Gouri-Shankar-85/VX-01/vx01_ws/src/vx01_control/aquatic/vx01_aquatic_control/README.md

# vx01_aquatic_control

Control nodes for future underwater locomotion integration.

---

## Package Structure

```
vx01_aquatic_control/
├── CMakeLists.txt
├── include
│   └── vx01_aquatic_control
├── package.xml
├── README.md
└── src

3 directories, 3 files
```

---

## Build

From the VX-01 workspace root:

```bash
cd ~/vx01_ws
colcon build --packages-select vx01_aquatic_control
source install/setup.bash
```
