Gouri-Shankar-85/VX-01/vx01_ws/src/vx01_control/locomotion/kinematics_reference/leg.JPG

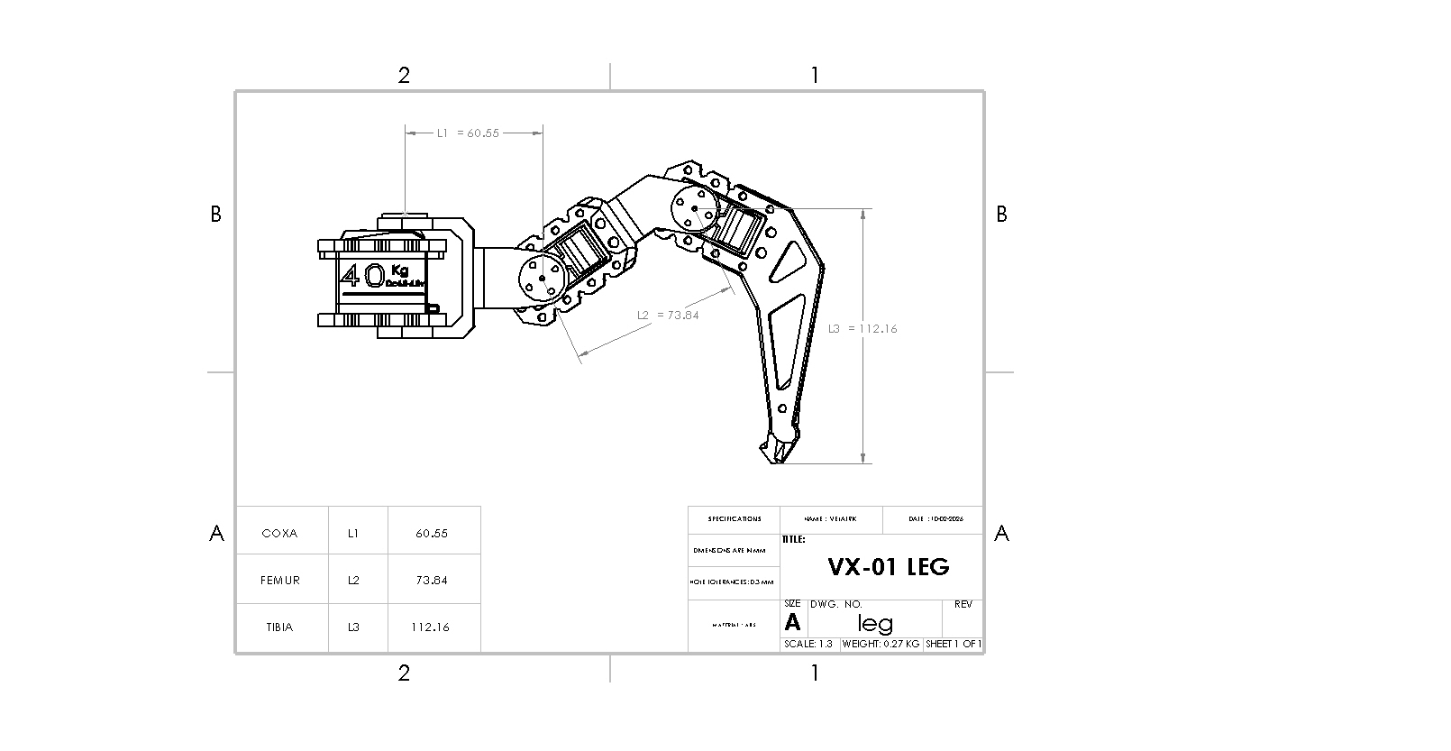
vx01_ws/src/vx01_control/locomotion/kinematics_reference/leg.JPG
