Gouri-Shankar-85/VX-01/vx01_ws/src/vx01_description/meshes/drone/prop_link_1.STL

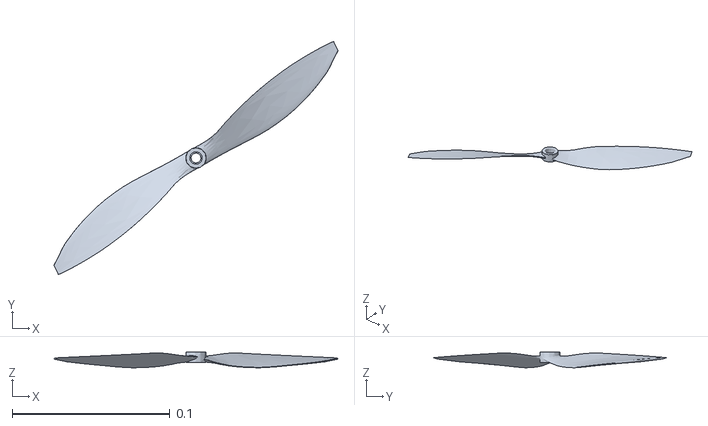
[picture p5: CAD file, 2026-02-22]
vx01_ws/src/vx01_description/meshes/drone/prop_link_1.STL
0.18 x 0.148 x 0.00996
