Gouri-Shankar-85/VX-01/vx01_ws/src/vx01_description/meshes/hexapod/tibia_link_5.STL

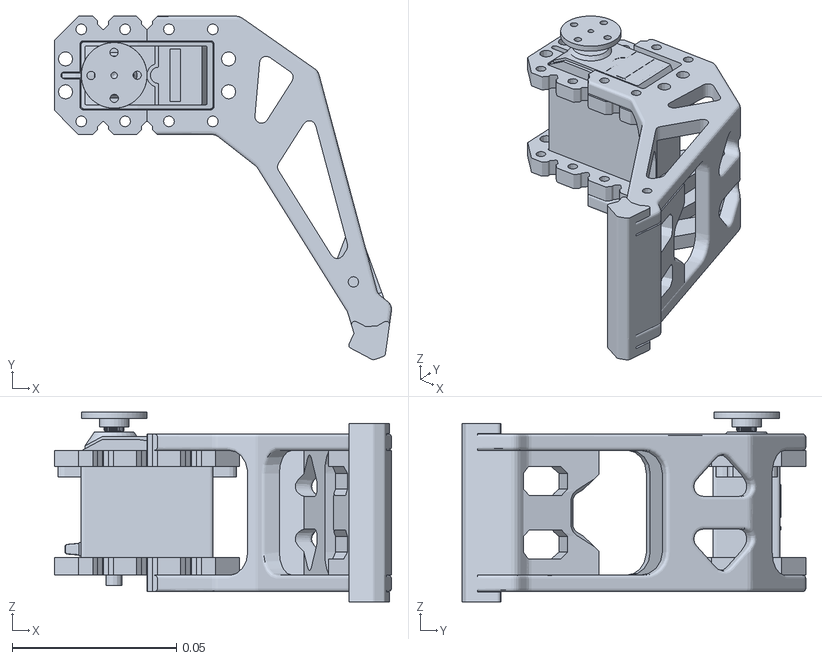
[picture p6: CAD file, 2026-02-22]
vx01_ws/src/vx01_description/meshes/hexapod/tibia_link_5.STL
0.103 x 0.105 x 0.0577
