Gouri-Shankar-85/VX-01/vx01_ws/src/vx01_description/meshes/sensors/depth_camera_link.STL

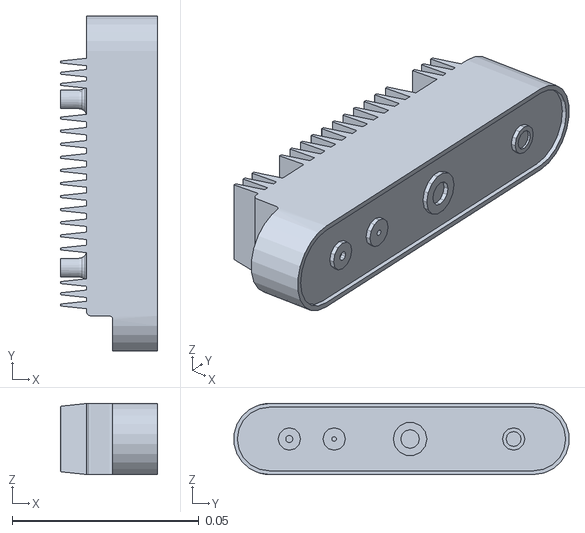
[picture p7: CAD file, 2026-02-19]
vx01_ws/src/vx01_description/meshes/sensors/depth_camera_link.STL
0.026 x 0.0896 x 0.019
