Gouri-Shankar-85/VX-01/vx01_ws/src/vx01_description/meshes/hexapod/femur_link_0.STL

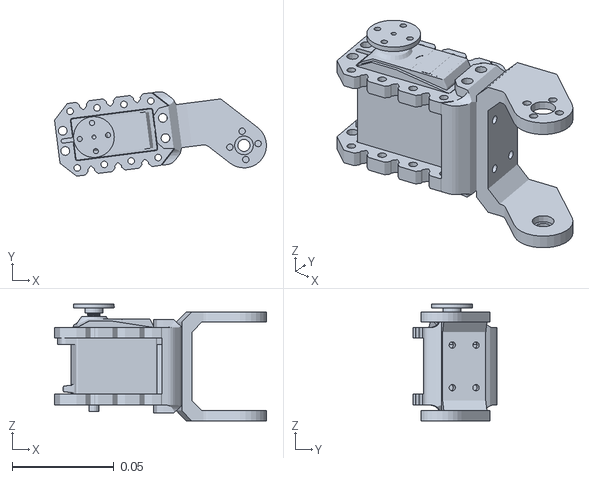
[picture p8: CAD file, 2026-02-22]
vx01_ws/src/vx01_description/meshes/hexapod/femur_link_0.STL
0.104 x 0.0415 x 0.0574
