Gouri-Shankar-85/VX-01/vx01_ws/src/vx01_description/meshes/sensors/imu_link.STL

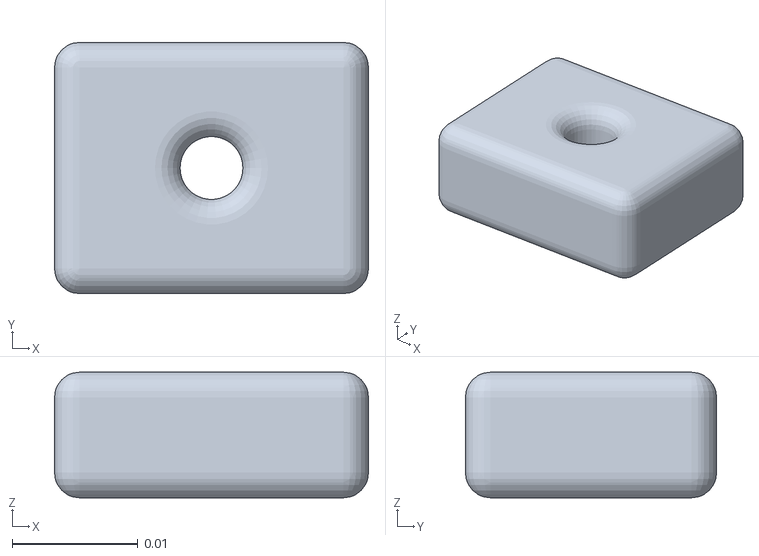
[picture p9: CAD file, 2026-02-19]
vx01_ws/src/vx01_description/meshes/sensors/imu_link.STL
0.025 x 0.02 x 0.01
