Gouri-Shankar-85/VX-01/vx01_ws/src/vx01_description/meshes/sensors/lidar_link.STL

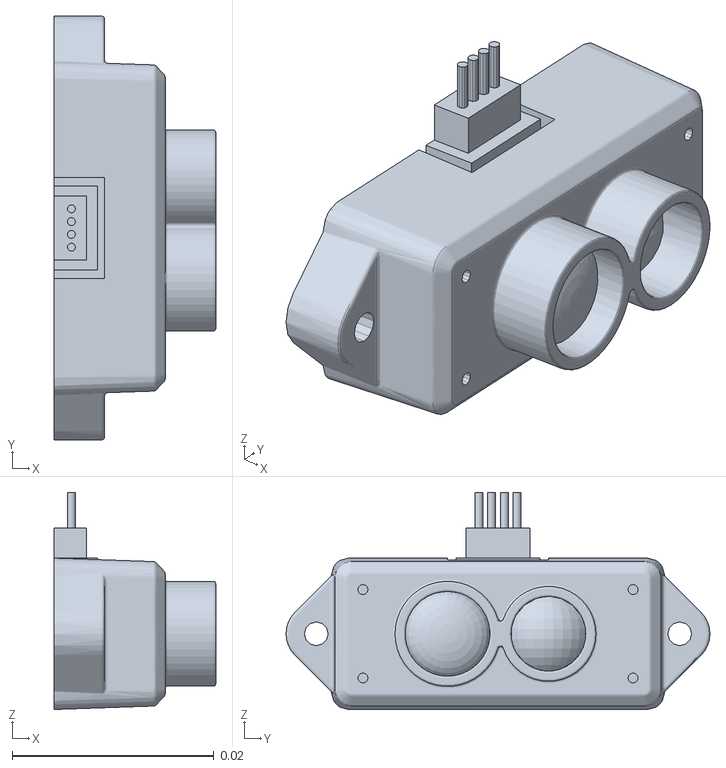
[picture p10: CAD file, 2026-02-19]
vx01_ws/src/vx01_description/meshes/sensors/lidar_link.STL
0.016 x 0.042 x 0.0215
