Gouri-Shankar-85/VX-01/vx01_ws/src/vx01_description/meshes/hexapod/femur_link_1.STL

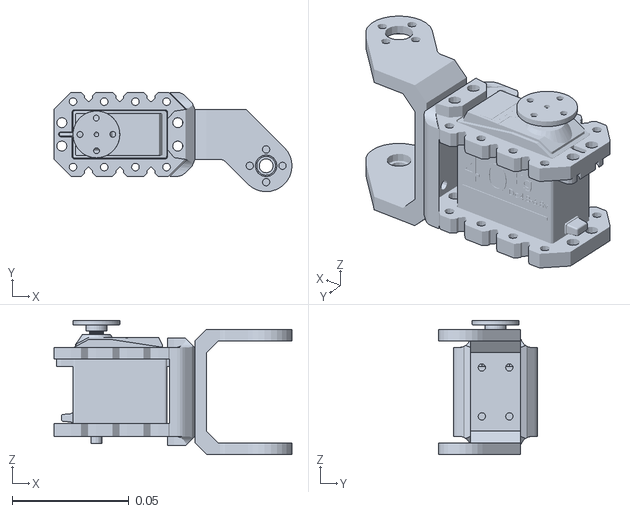
[picture p11: CAD file, 2026-02-22]
vx01_ws/src/vx01_description/meshes/hexapod/femur_link_1.STL
0.102 x 0.0425 x 0.0574
