Gouri-Shankar-85/VX-01/vx01_ws/src/vx01_description/meshes/hexapod/coxa_link_1.STL

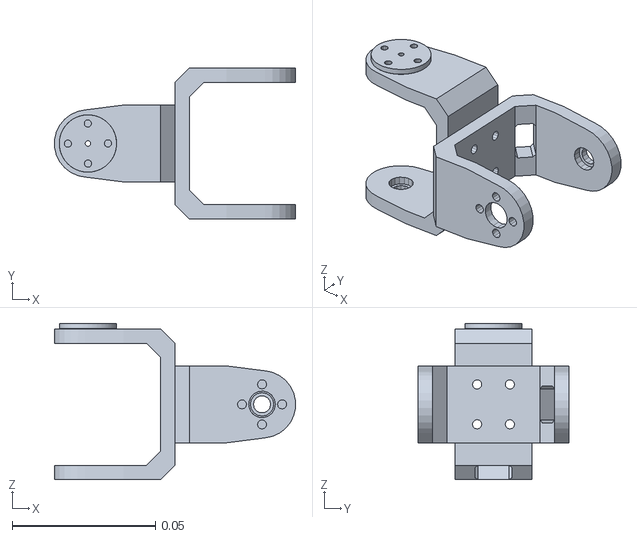
[picture p12: CAD file, 2026-02-22]
vx01_ws/src/vx01_description/meshes/hexapod/coxa_link_1.STL
0.0841 x 0.0526 x 0.0546
