Gouri-Shankar-85/VX-01/(list of files, cad)

Other CAD files:
vx01_ws/src/vx01_description/meshes/drone/prop_link_2.STL
vx01_ws/src/vx01_description/meshes/drone/prop_link_3.STL
vx01_ws/src/vx01_description/meshes/hexapod/tibia_link_2.STL
vx01_ws/src/vx01_description/meshes/drone/prop_link_0.STL
vx01_ws/src/vx01_description/meshes/hexapod/tibia_link_3.STL
vx01_ws/src/vx01_description/meshes/hexapod/femur_link_4.STL
vx01_ws/src/vx01_description/meshes/hexapod/coxa_link_5.STL
vx01_ws/src/vx01_description/meshes/hexapod/coxa_link_2.STL
vx01_ws/src/vx01_description/meshes/hexapod/femur_link_2.STL
vx01_ws/src/vx01_description/meshes/hexapod/tibia_link_0.STL
vx01_ws/src/vx01_description/meshes/hexapod/tibia_link_1.STL
vx01_ws/src/vx01_description/meshes/hexapod/coxa_link_3.STL
vx01_ws/src/vx01_description/meshes/hexapod/tibia_link_4.STL
vx01_ws/src/vx01_description/meshes/hexapod/femur_link_5.STL
vx01_ws/src/vx01_description/meshes/hexapod/coxa_link_4.STL
vx01_ws/src/vx01_description/meshes/hexapod/femur_link_3.STL
vx01_ws/src/vx01_description/meshes/hexapod/coxa_link_0.STL
