Gouri-Shankar-85/VX-01/vx01_ws/vx01_frame_tree.pdf

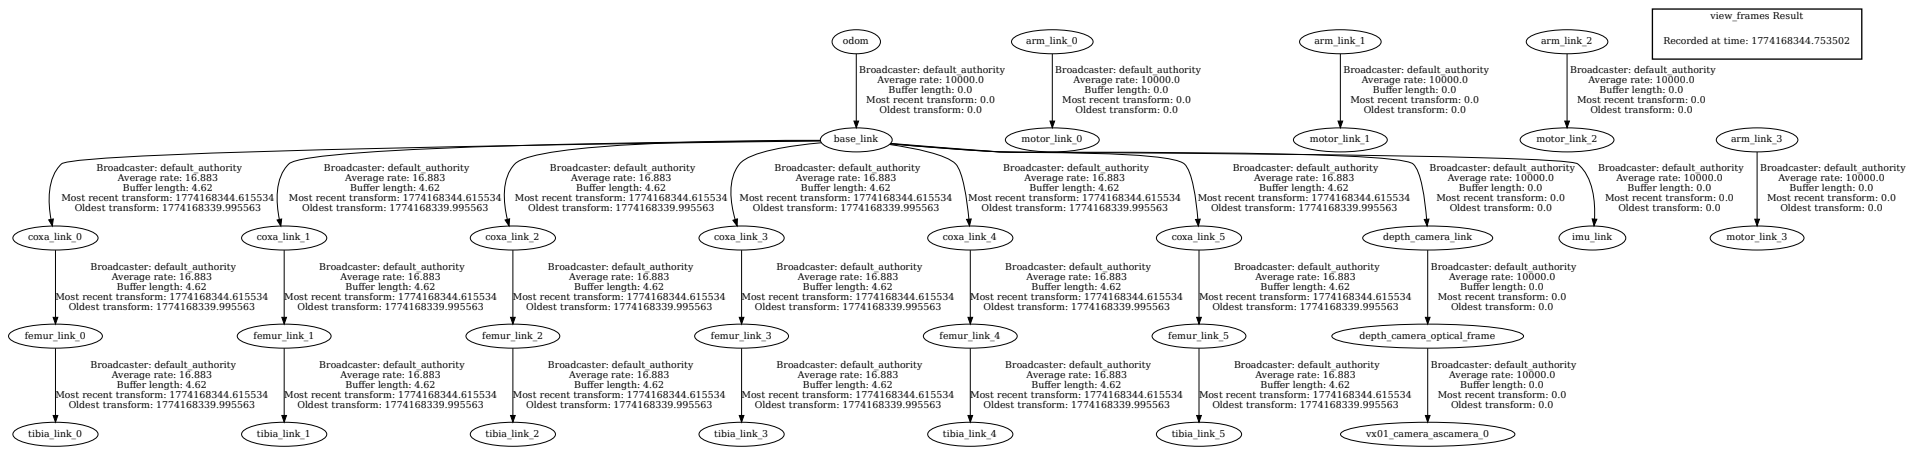
[picture p13: page 1]
view_frames Result; base_link; coxa_link_0; Broadcaster: default_authority Average rate: 16.883 Buffer length: 4.62; coxa_link_1; coxa_link_2; coxa_link_3; coxa_link_4; coxa_link_5; depth_camera_link; imu_link; femur_link_0; odom; femur_link_1; femur_link_2; femur_link_3; femur_link_4; femur_link_5; tibia_link_0; tibia_link_1; tibia_link_2; tibia_link_3; tibia_link_4; tibia_link_5; depth_camera_optical_frame; vx01_camera_ascamera_0; arm_link_0; motor_link_0; arm_link_1; motor_link_1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

Recorded at time: 1774168344.753502

Broadcaster: default_authority
Average rate: 10000.0
Buffer length: 0.0
Most recent transform: 0.0
Oldest transform: 0.0

Most recent transform: 1774168344.615534
Oldest transform: 1774168339.995563
