Gouri-Shankar-85/VX-01/PCB Files/VX-01.kicad_pcb

## KiCad design PCB Files/VX-01.kicad_pcb (2026-07-06)

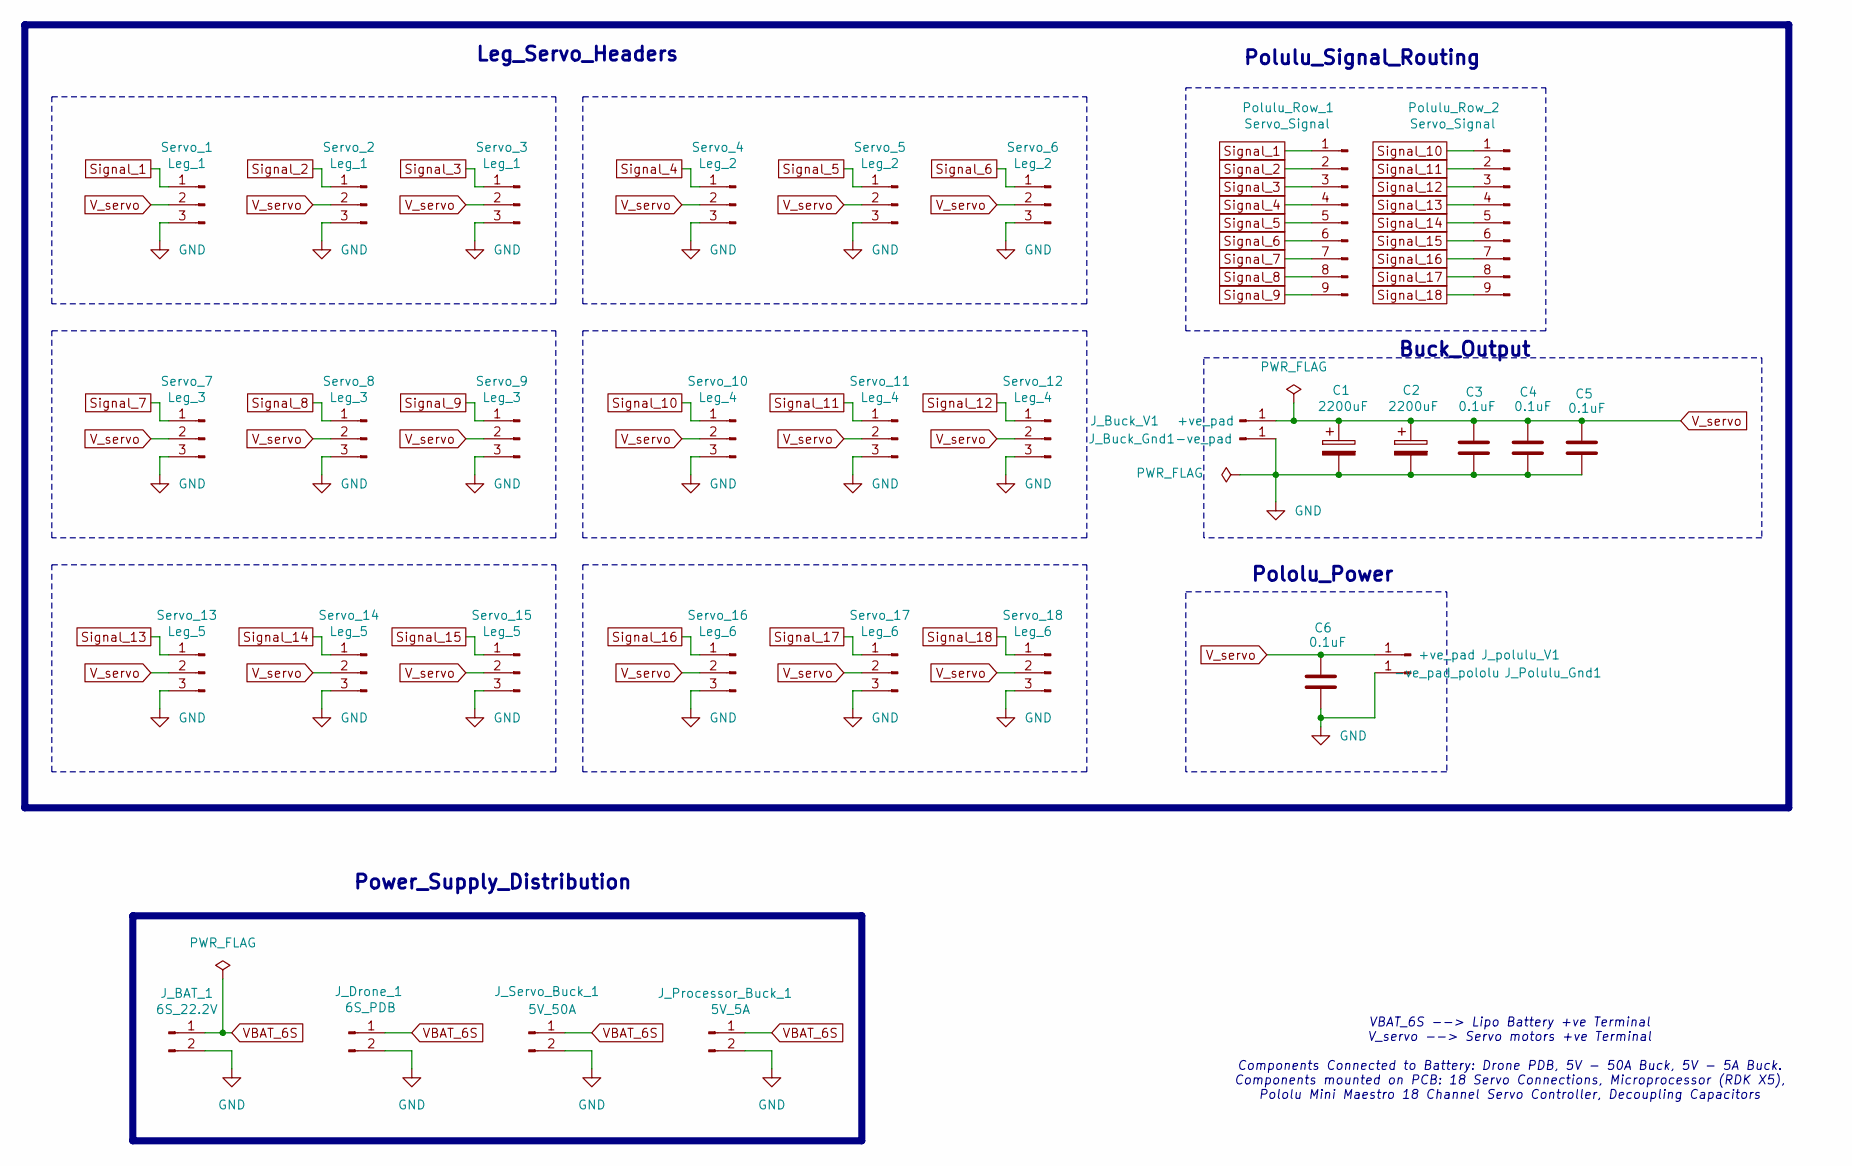
[picture p14: schematic VX-01.kicad_sch, VX - 01 Hybrid Robot Power Distribution Schematic]

Parts:
C1, C2: 2200uF; C_Radial_D12.5mm_H25.0mm_P5.00mm
C3, C4, C5, C6: 0.1uF; C_0805_2012Metric_Pad1.18x1.45mm_HandSolder
J_BAT_1: 6S_22.2V; XT-90F
J_Buck_Gnd1: -ve_pad; SolderWirePad_1x01_SMD_5x10mm
J_Buck_V1: +ve_pad; SolderWirePad_1x01_SMD_5x10mm
J_Drone_1: 6S_PDB; XT-90F
J_Polulu_Gnd1: -ve_pad_pololu; SolderWirePad_1x01_SMD_5x10mm
J_Processor_Buck_1: 5V_5A; AMASS_XT60-F_1x02_P7.20mm_Vertical
J_Servo_Buck_1: 5V_50A; AMASS_XT60-F_1x02_P7.20mm_Vertical
J_polulu_V1: +ve_pad; SolderWirePad_1x01_SMD_5x10mm
Polulu_Row_1, Polulu_Row_2: Servo_Signal; PinHeader_1x09_P2.54mm_Vertical
Servo_1, Servo_2, Servo_3: Leg_1; PinHeader_1x03_P2.54mm_Vertical
Servo_4, Servo_5, Servo_6: Leg_2; PinHeader_1x03_P2.54mm_Vertical
Servo_7, Servo_8, Servo_9: Leg_3; PinHeader_1x03_P2.54mm_Vertical
Servo_10, Servo_11, Servo_12: Leg_4; PinHeader_1x03_P2.54mm_Vertical
Servo_13, Servo_14, Servo_15: Leg_5; PinHeader_1x03_P2.54mm_Vertical
Servo_16, Servo_17, Servo_18: Leg_6; PinHeader_1x03_P2.54mm_Vertical

Connections:
GND: C1.2, C2.2, C3.2, C4.2, C5.2, C6.2, J_BAT_1.2, J_Buck_Gnd1.1, J_Drone_1.2, J_Polulu_Gnd1.1, J_Processor_Buck_1.2, J_Servo_Buck_1.2, Servo_1.3, Servo_2.3, Servo_3.3, Servo_4.3, Servo_5.3, Servo_6.3, Servo_7.3, Servo_8.3, Servo_9.3, Servo_10.3, Servo_11.3, Servo_12.3, Servo_13.3, Servo_14.3, Servo_15.3, Servo_16.3, Servo_17.3, Servo_18.3
Signal_1: Polulu_Row_1.1, Servo_1.1
Signal_2: Polulu_Row_1.2, Servo_2.1
Signal_3: Polulu_Row_1.3, Servo_3.1
Signal_4: Polulu_Row_1.4, Servo_4.1
Signal_5: Polulu_Row_1.5, Servo_5.1
Signal_6: Polulu_Row_1.6, Servo_6.1
Signal_7: Polulu_Row_1.7, Servo_7.1
Signal_8: Polulu_Row_1.8, Servo_8.1
Signal_9: Polulu_Row_1.9, Servo_9.1
Signal_10: Polulu_Row_2.1, Servo_10.1
Signal_11: Polulu_Row_2.2, Servo_11.1
Signal_12: Polulu_Row_2.3, Servo_12.1
Signal_13: Polulu_Row_2.4, Servo_13.1
Signal_14: Polulu_Row_2.5, Servo_14.1
Signal_15: Polulu_Row_2.6, Servo_15.1
Signal_16: Polulu_Row_2.7, Servo_16.1
Signal_17: Polulu_Row_2.8, Servo_17.1
Signal_18: Polulu_Row_2.9, Servo_18.1
VBAT_6S: J_BAT_1.1, J_Drone_1.1, J_Processor_Buck_1.1, J_Servo_Buck_1.1
V_servo: C1.1, C2.1, C3.1, C4.1, C5.1, C6.1, J_Buck_V1.1, J_polulu_V1.1, Servo_1.2, Servo_2.2, Servo_3.2, Servo_4.2, Servo_5.2, Servo_6.2, Servo_7.2, Servo_8.2, Servo_9.2, Servo_10.2, Servo_11.2, Servo_12.2, Servo_13.2, Servo_14.2, Servo_15.2, Servo_16.2, Servo_17.2, Servo_18.2

Notes on the sheet:
Leg_Servo_Headers
Pololu_Power
Polulu_Signal_Routing
Buck_Output
VBAT_6S --> Lipo Battery +ve Terminal V_servo --> Servo motors +ve Terminal Components Connected to Battery: Drone PDB, 5V - 50A Buck, 5V - 5A Buck. Components mounted on PCB: 18 Servo Connections, Microprocessor (RDK X5), Pololu Mini Maestro 18 Channel Servo Controller, Decoupling Capacitors
Power_Supply_Distribution

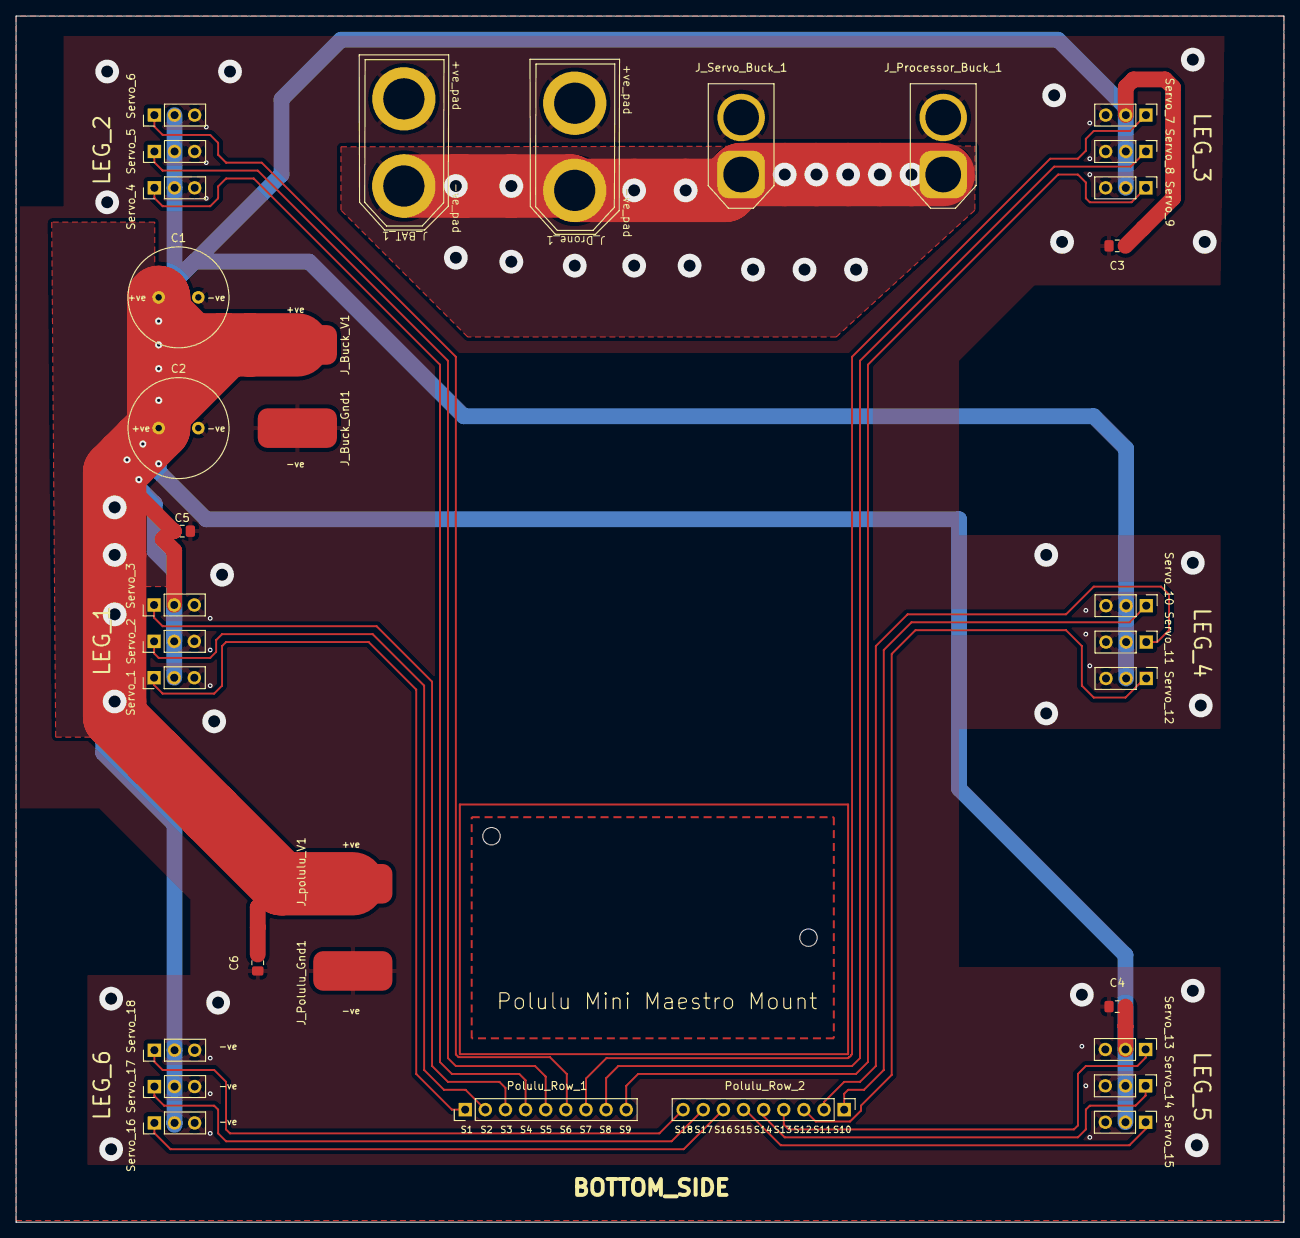
[picture p15: board VX-01.kicad_pcb from above]

Board: 2 copper layers, 160.0 x 152.2 mm, 34 parts (0 on the bottom side), 21 nets.
