Gouri-Shankar-85/VX-01/vx01_ws/src/vx01_bringup/config/vx01_controller_manager.yaml

#  vx01_controller_manager.yaml

controller_manager:
  ros__parameters:
    update_rate: 1000
    use_sim_time: true

    joint_state_broadcaster:
      type: joint_state_broadcaster/JointStateBroadcaster

    leg_0_controller:
      type: joint_trajectory_controller/JointTrajectoryController

    leg_1_controller:
      type: joint_trajectory_controller/JointTrajectoryController

    leg_2_controller:
      type: joint_trajectory_controller/JointTrajectoryController

    leg_3_controller:
      type: joint_trajectory_controller/JointTrajectoryController

    leg_4_controller:
      type: joint_trajectory_controller/JointTrajectoryController

    leg_5_controller:
      type: joint_trajectory_controller/JointTrajectoryController

    drone_arm_controller:
      type: joint_trajectory_controller/JointTrajectoryController

joint_state_broadcaster:
  ros__parameters:
    use_sim_time: true

leg_0_controller:
  ros__parameters:
    use_sim_time: true
    joints:
      - coxa_leg0_joint
      - femur_leg0_joint
      - tibia_leg0_joint
    command_interfaces:
      - position
    state_interfaces:
      - position
    state_publish_rate: 50.0
    action_monitor_rate: 20.0
    allow_partial_joints_goal: false
    allow_integration_in_goal_trajectories: true
    constraints:
      stopped_velocity_tolerance: 0.1
      goal_time: 0.0
      coxa_leg0_joint:  { trajectory: 1.5, goal: 0.8 }
      femur_leg0_joint: { trajectory: 1.5, goal: 0.8 }
      tibia_leg0_joint: { trajectory: 1.5, goal: 0.8 }

leg_1_controller:
  ros__parameters:
    use_sim_time: true
    joints:
      - coxa_leg1_joint
      - femur_leg1_joint
      - tibia_leg1_joint
    command_interfaces:
      - position
    state_interfaces:
      - position
    state_publish_rate: 50.0
    action_monitor_rate: 20.0
    allow_partial_joints_goal: false
    allow_integration_in_goal_trajectories: true
    constraints:
      stopped_velocity_tolerance: 0.1
      goal_time: 0.0
      coxa_leg1_joint:  { trajectory: 1.5, goal: 0.8 }
      femur_leg1_joint: { trajectory: 1.5, goal: 0.8 }
      tibia_leg1_joint: { trajectory: 1.5, goal: 0.8 }

leg_2_controller:
  ros__parameters:
    use_sim_time: true
    joints:
      - coxa_leg2_joint
      - femur_leg2_joint
      - tibia_leg2_joint
    command_interfaces:
      - position
    state_interfaces:
      - position
    state_publish_rate: 50.0
    action_monitor_rate: 20.0
    allow_partial_joints_goal: false
    allow_integration_in_goal_trajectories: true
    constraints:
      stopped_velocity_tolerance: 0.1
      goal_time: 0.0
      coxa_leg2_joint:  { trajectory: 1.5, goal: 0.8 }
      femur_leg2_joint: { trajectory: 1.5, goal: 0.8 }
      tibia_leg2_joint: { trajectory: 1.5, goal: 0.8 }

leg_3_controller:
  ros__parameters:
    use_sim_time: true
    joints:
      - coxa_leg3_joint
      - femur_leg3_joint
      - tibia_leg3_joint
    command_interfaces:
      - position
    state_interfaces:
      - position
    state_publish_rate: 50.0
    action_monitor_rate: 20.0
    allow_partial_joints_goal: false
    allow_integration_in_goal_trajectories: true
    constraints:
      stopped_velocity_tolerance: 0.1
      goal_time: 0.0
      coxa_leg3_joint:  { trajectory: 1.5, goal: 0.8 }
      femur_leg3_joint: { trajectory: 1.5, goal: 0.8 }
      tibia_leg3_joint: { trajectory: 1.5, goal: 0.8 }

leg_4_controller:
  ros__parameters:
    use_sim_time: true
    joints:
      - coxa_leg4_joint
      - femur_leg4_joint
      - tibia_leg4_joint
    command_interfaces:
      - position
    state_interfaces:
      - position
    state_publish_rate: 50.0
    action_monitor_rate: 20.0
    allow_partial_joints_goal: false
    allow_integration_in_goal_trajectories: true
    constraints:
      stopped_velocity_tolerance: 0.1
      goal_time: 0.0
      coxa_leg4_joint:  { trajectory: 1.5, goal: 0.8 }
      femur_leg4_joint: { trajectory: 1.5, goal: 0.8 }
      tibia_leg4_joint: { trajectory: 1.5, goal: 0.8 }

leg_5_controller:
  ros__parameters:
    use_sim_time: true
    joints:
      - coxa_leg5_joint
      - femur_leg5_joint
      - tibia_leg5_joint
    command_interfaces:
      - position
    state_interfaces:
      - position
    state_publish_rate: 50.0
    action_monitor_rate: 20.0
    allow_partial_joints_goal: false
    allow_integration_in_goal_trajectories: true
    constraints:
      stopped_velocity_tolerance: 0.1
      goal_time: 0.0
      coxa_leg5_joint:  { trajectory: 1.5, goal: 0.8 }
      femur_leg5_joint: { trajectory: 1.5, goal: 0.8 }
      tibia_leg5_joint: { trajectory: 1.5, goal: 0.8 }

drone_arm_controller:
  ros__parameters:
    use_sim_time: true
    joints:
      - arm_joint0
      - arm_joint1
      - arm_joint2
      - arm_joint3
    command_interfaces:
      - position
    state_interfaces:
      - position
    interpolation_method: splines
    state_publish_rate: 50.0
    action_monitor_rate: 20.0
    allow_partial_joints_goal: true
    goal_time_tolerance: 0.5
    allow_nonzero_velocity_at_trajectory_end: false
    constraints:
      stopped_velocity_tolerance: 0.05
      goal_time: 0.0
      arm_joint0: { trajectory: 0.2, goal: 0.1 }
      arm_joint1: { trajectory: 0.2, goal: 0.1 }
      arm_joint2: { trajectory: 0.2, goal: 0.1 }
      arm_joint3: { trajectory: 0.2, goal: 0.1 }
ign_ros2_control:
  ros__parameters:
    gains:
      coxa_leg0_joint: {p: 50.0, i: 0.01, d: 2.0}
      femur_leg0_joint: {p: 50.0, i: 0.01, d: 2.0}
      tibia_leg0_joint: {p: 50.0, i: 0.01, d: 2.0}
      coxa_leg1_joint: {p: 50.0, i: 0.01, d: 2.0}
      femur_leg1_joint: {p: 50.0, i: 0.01, d: 2.0}
      tibia_leg1_joint: {p: 50.0, i: 0.01, d: 2.0}
      coxa_leg2_joint: {p: 50.0, i: 0.01, d: 2.0}
      femur_leg2_joint: {p: 50.0, i: 0.01, d: 2.0}
      tibia_leg2_joint: {p: 50.0, i: 0.01, d: 2.0}
      coxa_leg3_joint: {p: 50.0, i: 0.01, d: 2.0}
      femur_leg3_joint: {p: 50.0, i: 0.01, d: 2.0}
      tibia_leg3_joint: {p: 50.0, i: 0.01, d: 2.0}
      coxa_leg4_joint: {p: 50.0, i: 0.01, d: 2.0}
      femur_leg4_joint: {p: 50.0, i: 0.01, d: 2.0}
      tibia_leg4_joint: {p: 50.0, i: 0.01, d: 2.0}
      coxa_leg5_joint: {p: 50.0, i: 0.01, d: 2.0}
      femur_leg5_joint: {p: 50.0, i: 0.01, d: 2.0}
      tibia_leg5_joint: {p: 50.0, i: 0.01, d: 2.0}
      arm_joint0: {p: 20.0, i: 0.0, d: 1.0}
      arm_joint1: {p: 20.0, i: 0.0, d: 1.0}
      arm_joint2: {p: 20.0, i: 0.0, d: 1.0}
      arm_joint3: {p: 20.0, i: 0.0, d: 1.0}

controller_manager:
  ros__parameters:
    gains:
      coxa_leg0_joint: {p: 50.0, i: 0.01, d: 2.0}
      femur_leg0_joint: {p: 50.0, i: 0.01, d: 2.0}
      tibia_leg0_joint: {p: 50.0, i: 0.01, d: 2.0}
      coxa_leg1_joint: {p: 50.0, i: 0.01, d: 2.0}
      femur_leg1_joint: {p: 50.0, i: 0.01, d: 2.0}
      tibia_leg1_joint: {p: 50.0, i: 0.01, d: 2.0}
      coxa_leg2_joint: {p: 50.0, i: 0.01, d: 2.0}
      femur_leg2_joint: {p: 50.0, i: 0.01, d: 2.0}
      tibia_leg2_joint: {p: 50.0, i: 0.01, d: 2.0}
      coxa_leg3_joint: {p: 50.0, i: 0.01, d: 2.0}
      femur_leg3_joint: {p: 50.0, i: 0.01, d: 2.0}
      tibia_leg3_joint: {p: 50.0, i: 0.01, d: 2.0}
      coxa_leg4_joint: {p: 50.0, i: 0.01, d: 2.0}
      femur_leg4_joint: {p: 50.0, i: 0.01, d: 2.0}
      tibia_leg4_joint: {p: 50.0, i: 0.01, d: 2.0}
      coxa_leg5_joint: {p: 50.0, i: 0.01, d: 2.0}
      femur_leg5_joint: {p: 50.0, i: 0.01, d: 2.0}
      tibia_leg5_joint: {p: 50.0, i: 0.01, d: 2.0}
      arm_joint0: {p: 20.0, i: 0.0, d: 1.0}
      arm_joint1: {p: 20.0, i: 0.0, d: 1.0}
      arm_joint2: {p: 20.0, i: 0.0, d: 1.0}
      arm_joint3: {p: 20.0, i: 0.0, d: 1.0}
