Gouri-Shankar-85/VX-01/vx01_ws/src/vx01_mavros_bridge/src/motor_commander.cpp

#include "vx01_mavros_bridge/motor_commander.hpp"
#include <tf2/LinearMath/Quaternion.h>
#include <algorithm>

namespace vx01_mavros_bridge {

MotorCommander::MotorCommander(rclcpp::Node::SharedPtr node)
    : node_(node),
      roll_(0.0), pitch_(0.0),
      yaw_(0.0), thrust_(0.0),
      is_active_(false) {

    attitude_pub_ = node_->create_publisher<mavros_msgs::msg::AttitudeTarget>(
        "/vx01/mavros/setpoint_raw/attitude", 10);

    RCLCPP_INFO(node_->get_logger(), "MotorCommander initialized");
}

void MotorCommander::activate() {
    is_active_ = true;
    RCLCPP_INFO(node_->get_logger(), "MotorCommander activated");
}

void MotorCommander::deactivate() {
    emergencyStop();
    is_active_ = false;
    RCLCPP_INFO(node_->get_logger(), "MotorCommander deactivated");
}

bool MotorCommander::isActive() const {
    return is_active_;
}

void MotorCommander::setRoll(double roll) {
    roll_ = roll;
}

void MotorCommander::setPitch(double pitch) {
    pitch_ = pitch;
}

void MotorCommander::setYaw(double yaw) {
    yaw_ = yaw;
}

void MotorCommander::setThrust(double thrust) {
    thrust_ = std::max(0.0, std::min(1.0, thrust));
}

void MotorCommander::setAttitudeThrust(double roll, double pitch,
                                        double yaw, double thrust) {
    setRoll(roll);
    setPitch(pitch);
    setYaw(yaw);
    setThrust(thrust);
}

void MotorCommander::hover() {
    setAttitudeThrust(0.0, 0.0, yaw_, 0.5);
    publishCommands();
    RCLCPP_INFO(node_->get_logger(), "Hovering");
}

void MotorCommander::land() {
    setAttitudeThrust(0.0, 0.0, yaw_, 0.3);
    publishCommands();
    RCLCPP_INFO(node_->get_logger(), "Landing");
}

void MotorCommander::emergencyStop() {
    setAttitudeThrust(0.0, 0.0, 0.0, 0.0);
    publishCommands();
    RCLCPP_WARN(node_->get_logger(), "EMERGENCY STOP");
}

void MotorCommander::publishCommands() {
    if (!is_active_) {
        return;
    }

    auto msg = mavros_msgs::msg::AttitudeTarget();
    msg.header.stamp = node_->now();
    msg.header.frame_id = "base_link";

    msg.type_mask =
        mavros_msgs::msg::AttitudeTarget::IGNORE_ROLL_RATE |
        mavros_msgs::msg::AttitudeTarget::IGNORE_PITCH_RATE |
        mavros_msgs::msg::AttitudeTarget::IGNORE_YAW_RATE;

    tf2::Quaternion q;
    q.setRPY(roll_, pitch_, yaw_);

    msg.orientation.x = q.x();
    msg.orientation.y = q.y();
    msg.orientation.z = q.z();
    msg.orientation.w = q.w();
    msg.thrust = static_cast<float>(thrust_);

    attitude_pub_->publish(msg);
}

double MotorCommander::getRoll() const { return roll_; }
double MotorCommander::getPitch() const { return pitch_; }
double MotorCommander::getYaw() const { return yaw_; }
double MotorCommander::getThrust() const { return thrust_; }

} // namespace vx01_mavros_bridge
