Gouri-Shankar-85/VX-01/vx01_ws/src/vx01_bringup/config/hexapod/hexapod_joint_limits.yaml

joint_limits:

  # LEG 0
  coxa_leg0_joint:
    has_position_limits: true
    min_position: -1.5708   
    max_position: 1.5708    
    has_velocity_limits: true
    max_velocity: 3.14159     
    has_acceleration_limits: true
    max_acceleration: 10.0
    has_effort_limits: false

  femur_leg0_joint:
    has_position_limits: true
    min_position: -1.5708
    max_position: 1.5708
    has_velocity_limits: true
    max_velocity: 3.14159
    has_acceleration_limits: true
    max_acceleration: 10.0
    has_effort_limits: false

  tibia_leg0_joint:
    has_position_limits: true
    min_position: -1.5708   
    max_position: 1.5708          
    has_velocity_limits: true
    max_velocity: 3.14159
    has_acceleration_limits: true
    max_acceleration: 10.0
    has_effort_limits: false

  # LEG 1
  coxa_leg1_joint:
    has_position_limits: true
    min_position: -1.5708
    max_position: 1.5708
    has_velocity_limits: true
    max_velocity: 3.14159
    has_acceleration_limits: true
    max_acceleration: 10.0
    has_effort_limits: false

  femur_leg1_joint:
    has_position_limits: true
    min_position: -1.5708
    max_position: 1.5708
    has_velocity_limits: true
    max_velocity: 3.14159
    has_acceleration_limits: true
    max_acceleration: 10.0
    has_effort_limits: false

  tibia_leg1_joint:
    has_position_limits: true
    min_position: -1.5708
    max_position: 1.5708
    has_velocity_limits: true
    max_velocity: 3.14159
    has_acceleration_limits: true
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
    has_effort_limits: false

  tibia_leg5_joint:
    has_position_limits: true
    min_position: -1.5708
    max_position: 1.5708
    has_velocity_limits: true
    max_velocity: 3.14159
    has_acceleration_limits: true
    max_acceleration: 10.0
    has_effort_limits: false
