Gouri-Shankar-85/VX-01/vx01_ws/src/vx01_bringup/config/hexapod/hexapod_initial_positions.yaml

# Initial joint positions for hexapod VX01

initial_positions:
  # LEG 0
  coxa_leg0_joint:   0.0000
  femur_leg0_joint:  0.1222
  tibia_leg0_joint: -0.6981

  # LEG 1
  coxa_leg1_joint:   0.0000
  femur_leg1_joint:  0.1222
  tibia_leg1_joint: -0.6981

  # LEG 2
  coxa_leg2_joint:   0.0000
  femur_leg2_joint:  0.1222
  tibia_leg2_joint: -0.6981

  # LEG 3
  coxa_leg3_joint:   0.0000
  femur_leg3_joint:  0.1222
  tibia_leg3_joint: -0.6981

  # LEG 4
  coxa_leg4_joint:   0.0000
  femur_leg4_joint:  0.1222
  tibia_leg4_joint: -0.6981

  # LEG 5
  coxa_leg5_joint:   0.0000
  femur_leg5_joint:  0.1222
  tibia_leg5_joint: -0.6981
