Gouri-Shankar-85/VX-01/vx01_ws/src/vx01_bringup/config/drone/drone_initial_positions.yaml

# Initial positions for drone arm servos
# All arms start horizontal (0 degrees)
# Air mode   : arms at 0.0  (horizontal - standard quadcopter)
# Water mode : arms tilt    (varies based on thrust vectoring)

initial_positions:
  arm_joint0: 0.0
  arm_joint1: 0.0
  arm_joint2: 0.0
  arm_joint3: 0.0
