Gouri-Shankar-85/VX-01/vx01_ws/src/vx01_bringup/config/drone/drone_joint_limits.yaml

joint_limits:

  # ARM SERVO JOINTS
  # Roll axis (X-axis)
  # GPIO PWM on RDK X5

  arm_joint0:
    has_position_limits: true
    min_position: -1.5707963    
    max_position: 1.5707963     
    has_velocity_limits: true
    max_velocity: 1.5707963     
    has_acceleration_limits: true
    max_acceleration: 5.0
    has_effort_limits: false

  arm_joint1:
    has_position_limits: true
    min_position: -1.5707963
    max_position: 1.5707963
    has_velocity_limits: true
    max_velocity: 1.5707963
    has_acceleration_limits: true
    max_acceleration: 5.0
    has_effort_limits: false

  arm_joint2:
    has_position_limits: true
    min_position: -1.5707963
    max_position: 1.5707963
    has_velocity_limits: true
    max_velocity: 1.5707963
    has_acceleration_limits: true
    max_acceleration: 5.0
    has_effort_limits: false

  arm_joint3:
    has_position_limits: true
    min_position: -1.5707963
    max_position: 1.5707963
    has_velocity_limits: true
    max_velocity: 1.5707963
    has_acceleration_limits: true
    max_acceleration: 5.0
    has_effort_limits: false
