Gouri-Shankar-85/VX-01/vx01_ws/src/vx01_bringup/config/ardupilot_sim_bypass.param

DISARM_DELAY    10
ARMING_CHECK    0
FRAME_CLASS     1
FRAME_TYPE      1
BATT_MONITOR    0
FS_THR_ENABLE   0
FS_GCS_ENABLE   0
SERIAL0_PROTOCOL 2
SERIAL0_BAUD    0

AHRS_EKF_TYPE    3
EK3_ENABLE       1
EK2_ENABLE       0
EK3_IMU_MASK     1
EK3_GPS_CHECK    0
EK3_CHECK_THRESH 0.4
EK3_SRC1_POSXY   3
EK3_SRC1_VELXY   3
EK3_SRC1_POSZ    1
EK3_SRC1_VELZ    0
EK3_SRC1_YAW     1

COMPASS_USE    1
COMPASS_USE2   1
COMPASS_USE3   1
SIM_MAG_ENABLE 1
GPS_TYPE       1

MOT_PWM_MIN     1000
MOT_PWM_MAX     2000
MOT_SPIN_ARM    0.10
MOT_SPIN_MIN    0.15
MOT_THST_EXPO   0.65
MOT_THST_HOVER  0.600
MOT_SAFE_DISARM 0
MOT_SLEW_UP     0
MOT_SLEW_DN     0

RC1_MIN  1000
RC1_MAX  2000
RC1_TRIM 1500
RC2_MIN  1000
RC2_MAX  2000
RC2_TRIM 1500
RC3_MIN  1000
RC3_MAX  2000
RC3_TRIM 1000
RC4_MIN  1000
RC4_MAX  2000
RC4_TRIM 1500

ATC_ANG_RLL_P   4.0
ATC_ANG_PIT_P   4.0
ATC_ANG_YAW_P   4.0

ATC_RAT_RLL_P    0.10
ATC_RAT_RLL_I    0.10
ATC_RAT_RLL_D    0.003
ATC_RAT_RLL_FILT 20.0

ATC_RAT_PIT_P    0.10
ATC_RAT_PIT_I    0.10
ATC_RAT_PIT_D    0.003
ATC_RAT_PIT_FILT 20.0

ATC_RAT_YAW_P    0.18
ATC_RAT_YAW_I    0.018
ATC_RAT_YAW_D    0.0
ATC_RAT_YAW_FILT 5.0

ATC_THR_MIX_MAX  0.5
ATC_THR_MIX_MAN  0.5

INS_GYRO_FILTER  20
INS_ACCEL_FILTER 20

TKOFF_THR_MAX 1000
