Gouri-Shankar-85/VX-01/(commit log)

2026-02-11 cad kinematics reference
2026-02-13 leg controller lib
2026-02-16 servo interface lib
2026-02-16 servo config lib
2026-02-16 servo controller lib
2026-02-16 empty packages for des, perception and sim added
2026-02-17 drone hardware interface added
    [camera.urdf.xacro, drone.ros2_control.xacro, drone_controller_manager.yaml, drone_joint_limits.yaml, hexapod.ros2_control.xacro, hexapod_controller_manager.yaml, hexapod_joint_limits.yaml, imu.urdf.xacro]
2026-02-17 corrected the mavros bridge
    [flight_mode_manager.cpp, mavros_bridge.cpp, motor_commander.cpp, telemetry_handler.cpp]
2026-02-17 single leg test script
2026-02-19 hexapod urdf
    [base.xacro, leg_0.xacro, leg_1.xacro, leg_2.xacro, leg_3.xacro, leg_4.xacro, leg_5.xacro]
2026-02-19 drone & sensors urdf
    [arm_0.xacro, arm_1.xacro, arm_2.xacro, arm_3.xacro, base.xacro, camera.urdf.xacro, coxa_link_0.STL, coxa_link_1.STL]
2026-02-19 vx01.urdf.xacro main added
    [drone.ros2_control.xacro, hexapod.ros2_control.xacro, vx01.urdf.xacro]
2026-02-19 vx01 launch in rviz
    [base.xacro, depth_camera.xacro, drone_controller_manager.yaml, drone_joint_limits.yaml, imu.xacro, vx01.urdf.xacro]
2026-02-21 robot loaded in gazebo
    [arm_1.xacro, depth_camera.xacro, drone.ros2_control.xacro, drone_controller_manager.yaml, empty_world.sdf, hexapod.ros2_control.xacro, hexapod_controller_manager.yaml, hexapod_joint_limits.yaml]
2026-02-22 updated description
    [arm_0.xacro, arm_1.xacro, arm_2.xacro, arm_3.xacro, base.xacro, coxa_link_1.STL, coxa_link_2.STL, coxa_link_3.STL]
2026-02-22 changed controller for each leg
    [base.xacro, vx01.ros2_control.xacro, vx01.urdf.xacro, vx01_controller_manager.yaml, vx01_sim.xacro]
2026-02-24 docker added
    [leg_0.xacro, leg_1.xacro, leg_2.xacro, leg_3.xacro, leg_4.xacro, leg_5.xacro, vx01.ros2_control.xacro]
2026-02-24 dockerfile.sim updated for mounting src folder
2026-02-26 fix: joint tolerance added to ik
2026-02-26 haerdware iterface for hexapod updated
    [hexapod_controller_manager_hw.yaml, servo_mapping.yaml]
2026-02-26 eai_viewer - depth camera software
2026-02-26 software - depth camera
2026-03-06 camera sdk removed
2026-03-07 [fix]: hexapod kinematic calculation
2026-03-07 fix: hexapod joint limits changed
    [hexapod_joint_limits.yaml, leg_0.xacro, leg_1.xacro, leg_2.xacro, leg_3.xacro, leg_4.xacro, leg_5.xacro, vx01.ros2_control.xacro]
2026-03-07 coxa upper limit changed
    [leg_0.xacro, leg_1.xacro, leg_2.xacro, leg_3.xacro, leg_4.xacro, leg_5.xacro]
2026-03-08 fix(locomotion): slow gait timer to block period to stop controller preemption
2026-03-08 fix(config): adjust home_z and step_height to keep tibia IK within servo limits
2026-03-08 fix(ik): correct home position from FK of standby pose to keep joints within limits
2026-03-08 fix(locomotion): slow step_period and add use_sim_time to unblock joint execution in Gazebo
2026-03-08 fix(locomotion): remove velocity scaling so open-loop gait actually translates feet
2026-03-08 fix(gait): correct Group A drag_sub ordering so feet don't teleport at swing→drag transitions
2026-03-08 fix(locomotion): project stride onto leg frame axes for forward walking + fix posture
2026-03-08 fix(locomotion): correct stride axis — ik_y = -sin(alpha)*gait_y for forward walking
2026-03-08 fix: Bezier swing arc + full drag sweep for all 6 legs
2026-03-08 fix: projects the stride onto each leg's local frame using the mounting angle alpha
2026-03-08 fix(description): initial pose for femur and tibia changed
    [vx01.ros2_control.xacro]
2026-03-08 fix(description(: initial pose for hexapod sim changed
    [vx01.ros2_control.xacro]
2026-03-08 fix(description): revolute axis for tibia_leg5_joint fixed to -1
    [leg_5.xacro]
2026-03-08 fix(locomotion): rotate leg mounting angles -90° to map stride Y to body forward X
2026-03-08 fix(locomotion): project stride onto each leg's local axis via leg_angle for forward walk
2026-03-08 test: ik_y changed to have a leg frame calculation
2026-03-08 fix(gait): flip stride Y for left-side legs 2,3,4 to produce forward walk
2026-03-08 fix(gait): flip Y only for leg 3 to preserve tripod sync while walking forward
2026-03-08 fix(gait): flip stride Y for Group A legs (0,2,4) to preserve tripod sync and walk forward
2026-03-08 feat(body): add BodyKinematics and BodyTranslation modules; wire updateLeg through O-frame transform per reference
2026-03-08 fix(locomotion): pass (home_x - body_radius) as O-frame body_x into bodyToLegFrame to fix diagonal leg IK failures
2026-03-08 fix(config): reduce step_length to 50 to fit diagonal leg IK reach with home_x=222.8
2026-03-08 fix(config): reduce home_x to 190 and step_length to 80 to fit 3D arm reach constraint at z=-72.9
2026-03-09 fix: correct leg frame transform, gait timer rate, dt value, and remove premature update
2026-03-09 fix: reduce home_x and step_length to eliminate stretched leg posture
2026-03-09 fix(config): legs raised
2026-03-09 fix: project stride offset into leg-local frame in updateLeg, tune yaml for IK reachability
2026-03-09 fix: remove stride projection from updateLeg, increase tibia friction and add contact params
    [vx01_sim.xacro]
2026-03-09 fix: flip gait_y sign for opposite-side legs to produce forward walking
2026-03-10 fix:mount the workspace into the container.
2026-03-11 add(perception): perception nodes - victim detector, terrain classifier and mission nodes
    [yolov4-tiny.cfg]
2026-03-13 fix: hexapod hw controller and launch file update
    [hexapod_controller_manager.yaml, hexapod_controller_manager_hw.yaml, servo_mapping.yaml]
2026-03-13 Resolve merge conflicts, keep local launch file fixes
    [vx01.ros2_control.xacro]
2026-03-13 fix(hw): suppress write spam, add is_active_ guard, log errno on serial failure
    [hexapod_hardware_interface.cpp, servo_controller.cpp]
2026-03-13 fix(urdf): pass serial_port and baud_rate as xacro args instead of hardcoding
    [vx01.urdf.xacro]
2026-03-13 fix(hw): serial interface fixed
    [hexapod_controller_manager_hw.yaml, servo_mapping.yaml]
2026-03-13 fix: recoonection logic for e i/o
    [hexapod_hardware_interface.cpp]
2026-03-13 update : servo mapping coxa reversed
    [servo_mapping.yaml]
2026-03-14 fix : femur servo mapping reversed
    [servo_mapping.yaml]
2026-03-14 feat(servo): add software interpolation for smooth joint motion
2026-03-14 feat(xacro): expose max_interpolation_step as hardware param
    [vx01.ros2_control.xacro]
2026-03-14 fix(ik): correct tibia sign — theta3 = M_PI - phi3 (positive = down)
2026-03-14 fix: step height fixed
    [servo_mapping.yaml]
2026-03-14 fix: correct forward walk axis, add multi-point bezier trajectory for leg lift
2026-03-14 fix: correct home_z and step_length to stay within kinematic workspace, add startup validation
2026-03-14 fix: rename stale gait_x/y/z vars in sampleLegAnglesAt, add cmath to gait_pattern header
2026-03-14 fix: pre-sample all waypoints atomically and use stateless IK in sampleLegAnglesAt
2026-03-19 fix (gait): movement in x frame
2026-03-20 fix: camera node message to vx01
2026-03-20 topic(camera): camera topics replaced with original topic name
2026-03-20 fix(locomotion): tripod gait sync, drag leg hold, and stride length
2026-03-21 fix: per-leg stride = cos(leg_angle)*T/2 for correct forward-walking coxa direction
2026-03-21 fix: negate swing/drag Y direction to compensate coxa reversed:true servo mapping
2026-03-21 fix: separate swing/drag send loops to prevent mid-motion interruption; step_height=70
2026-03-21 fix: femur=-0.9 tibia=0.6 gives 95.7% reach, ±16° coxa sweep, 30mm headroom for lift
2026-03-21 fix: bezier Z peak = full step_height (4*u*t factor); pre-walk sends correct phase position per leg
2026-03-21 fix: decouple theta1 coxa sweep from theta2/theta3 Z lift in sampleSwingAtGlobalT
2026-03-21 debug: print all swing waypoint angles per leg per block trigger
2026-03-21 fix: direct femur angle control for lift, tibia constant during swing, no IK coupling
2026-03-21 fix: use stance_femur/tibia directly in swing; no IK coupling; femur lifts correctly
2026-03-22 fix: add t=0 anchor point to swing trajectory to fix reduced lift on legs 1,3,5
2026-03-22 fix(camera): update topic names and frame rate in README
2026-03-22 feat: working victim detection with depth and camera intrinsics
2026-03-22 feat: full robot bringup working — hw, camera, IMU, TF tree and mapping all in one launch
    [depth_camera.xacro, imu.xacro, vx01.urdf.xacro]
2026-03-24 regenerate package-lock.json with roslib and socket.io deps
2026-03-25 fix(locomotion): create gait timer on executor thread, not startup thread
2026-03-25 fix: serial port for polulu changed in xacro
    [vx01.ros2_control.xacro]
2026-03-25 removed spi and i2c from dockerfile
2026-03-26 test (hexapod) : introduced ros2 transformatons for body to leg transforms
2026-03-27 fix(locomotion): loosen stand-up tolerances to fix marginal leg 2 abort
2026-03-27 fix(locomotion): derive home pose from xacro FK and raise controller trajectory tolerance
    [vx01_controller_manager.yaml]
2026-03-27 fix(locomotion): replace fixed-Y stride with per-leg cmd_vel projection for correct walking
2026-04-05 feat: mount workspace volumes to ROS container and update RTL service call to use SetMode instead of CommandBool
2026-04-05 feat: implement ArduPilot SITL integration, hybrid mode manager, and aerial controller nodes
    [vx01.urdf.xacro]
2026-04-05 chore: migrate ArduPilot simulation to Ignition Gazebo and update SITL launch configuration
    [vx01.urdf.xacro]
2026-04-05 chore: update ArduPilot SITL model to JSON and correct plugin name in URDF
    [vx01.urdf.xacro]
2026-04-05 feat: enable IMU and sensor plugins with ogre2 render engine in empty_world.sdf
    [empty_world.sdf]
2026-04-05 fix: update imuName reference from imu_link to base_link in gazebo plugin configuration
    [vx01.urdf.xacro]
2026-04-05 fix: update IMU topic configuration and sensor name reference for Gazebo bridge compatibility
    [imu.xacro, vx01.urdf.xacro]
2026-04-05 refactor: update ArduPilot simulation arguments and switch MAVROS connection to TCP port 5760
2026-04-05 refactor: remove redundant whitespace and unused propeller joints from controller configuration
    [vx01_controller_manager.yaml]
2026-04-05 refactor: remove propeller joint interfaces from ros2_control configuration
    [vx01.ros2_control.xacro]
2026-04-05 feat: add velocity command and state interfaces for four propeller joints to ros2_control configuration
    [vx01.ros2_control.xacro]
2026-04-05 feat: initialize backend node_modules and update robot URDF configuration
    [tf_mini.xacro, vx01.urdf.xacro, vx01_controller_manager.yaml]
2026-04-05 feat: add victim image capture with unique IDs and update dashboard UI with victim tracking and telemetry
    [depth_camera.xacro, vx01_controller_manager.yaml]
2026-04-05 feat: implement asynchronous half-cycle gait control, add automated MAVROS arming bypass, and tune RTAB-Map visual odometry parameters
2026-04-05 feat: add ArduPilot simulation bypass parameters, implement cycle-based trajectory synchronization in locomotion, and tune RTAB-Map simulation settings.
    [ardupilot_sim_bypass.parm]
2026-04-05 refactor: update gait parameters and hardcode leg coxa angles for improved locomotion control
2026-04-05 refactor: optimize RTAB-Map odometry parameters and update force-arm sequence to STABILIZE mode for improved reliability
2026-04-06 feat: switch ArduPilot-MAVROS transport to UDP and optimize simulation parameters for stable connection
    [ardupilot_sim_bypass.parm]
2026-04-06 refactor: optimize gait trajectory generation with central-difference velocities, update walk parameters, and improve MAVROS connection stability.
2026-04-08 refactor: switch MAVROS connection from TCP to UDP for improved simulation stability
2026-04-08 refactor: implement leg-to-body frame transformations, update gait parameters for tripod stability, and correct ArduPilot plugin configuration.
    [ardupilot_sim_bypass.parm, vx01.urdf.xacro]
2026-04-08 fix: update ArduPilot serial output configuration and plugin path/name in simulation files
    [vx01.urdf.xacro]
2026-04-08 fix: update ArduPilot plugin reference and configure system plugin paths for Gazebo simulation
    [vx01.urdf.xacro]
2026-04-08 feat: add rosbridge_server to launch configuration and fix ArduPilotPlugin library path in URDF
    [vx01.urdf.xacro]
2026-04-08 refactor: rename ArduPilot config file extension and update MAVROS connection port to 14555
    [ardupilot_sim_bypass.param, ardupilot_sim_bypass.parm]
2026-04-08 chore: update ArduPilot SITL model and switch MAVROS connection to TCP
2026-04-08 chore: update FRAME_TYPE to 0 and increase launch sequence startup delays
2026-04-08 feat: load ArduPilot default parameters and remove redundant MAVROS frame configuration services
2026-04-08 chore: increase arm_vehicle timer delay to 120 seconds in hybrid simulation launch
2026-04-08 refactor: remove redundant vehicle arming timer actions in hybrid simulation launch file
2026-04-08 refactor: update MAVROS command topics, increase velocity publish rate, and simplify drone arming logic
2026-04-08 refactor: migrate aerial controller and dashboard to use TwistStamped for velocity commands
2026-04-08 feat: disable disarm delay and update arming logic to trigger heartbeat only upon successful arming
    [ardupilot_sim_bypass.param]
2026-04-09 refactor: remove redundant ArduPilot parameters and update launch file to prioritize custom bypass configuration
    [ardupilot_sim_bypass.param]
2026-04-09 fix: update ROS message type and include header timestamps in takeoff command velocity publisher
2026-04-09 fix: standardize velocity command header timestamps and zero out dashboard ROS message stamps
2026-04-09 feat: update ArduPilotPlugin configuration with improved motor control parameters and lock-step synchronization
    [vx01.urdf.xacro]
2026-04-09 refactor: move ArduPilotPlugin configuration from URDF to world file
    [empty_world.sdf, vx01.urdf.xacro]
2026-04-09 fix: update ArduPilotPlugin name to match library expectations
    [empty_world.sdf]
2026-04-21 refactor: update hexapod kinematics, gait trajectory interpolation, and default configuration parameters while adding a walk test script.
2026-04-21 fix: invert joint angle calculation for cmd2 in hexapod node
2026-04-21 fix: invert leg joint angle calculations to correct kinematic orientation
2026-04-21 refactor: update kinematics, gait parameters, and add Bézier trajectory support for improved locomotion stability
    [hexapod.yaml]
2026-04-21 chore: update hexapod home foot position parameters for improved body clearance and stance geometry
    [hexapod.yaml]
2026-04-21 feat: implement direct joint command override for stand pose and update gait parameters
2026-04-24 refactor: move ArduPilot SITL plugin configuration from world file to robot URDF
    [empty_world.sdf, vx01.urdf.xacro]
2026-04-24 fix: update MAVROS QoS, add multicopter motor plugins, and switch SITL to JSON model
    [vx01.urdf.xacro]
2026-04-24 fix: update ArduPilotPlugin namespace to ignition::gazebo::systems
    [vx01.urdf.xacro]
2026-04-24 fix: update ArduPilotPlugin name to match expected plugin identifier
    [vx01.urdf.xacro]
2026-04-24 feat: add manual teleop node, improve flight manager robustness, and update drone URDF and simulation parameters.
    [ardupilot_sim_bypass.param, base.xacro, vx01.urdf.xacro]
2026-04-24 fix: adjust MAVROS parameter timeouts, reorder ArduPilot launch arguments, and update bypass parameters for simulation stability
    [ardupilot_sim_bypass.param]
2026-04-24 feat: configure ArduPilot EKF3 parameters and update motor constants in URDF
    [ardupilot_sim_bypass.param, vx01.urdf.xacro]
2026-04-24 chore: configure ArduPilot RC and motor parameters and increase URDF motor multipliers
    [ardupilot_sim_bypass.param, vx01.urdf.xacro]
2026-04-24 refactor: update motor turning directions, increase motor constants, and remove robotNamespace from multicopter plugins
    [vx01.urdf.xacro]
2026-04-24 chore: update motor constants and rotor velocity slowdown parameters in URDF motor models
    [vx01.urdf.xacro]
2026-04-24 feat: add robotNamespace to multicopter motor model plugins in URDF
    [vx01.urdf.xacro]
2026-04-24 chore: disable lock_step in URDF and remove serial port configuration from ArduPilot parameters
    [ardupilot_sim_bypass.param, vx01.urdf.xacro]
2026-04-24 refactor: update motor multipliers, constants, and simulation slowdown parameters in URDF
    [vx01.urdf.xacro]
2026-04-24 fix: increase motor multiplier values in URDF to correct propulsion output scale
    [vx01.urdf.xacro]
2026-04-24 fix: remove propeller collision meshes to resolve physics engine instability
    [arm_0.xacro, arm_1.xacro, arm_2.xacro, arm_3.xacro]
2026-04-24 chore: update base inertia properties and reconfigure propeller servo limits
    [base.xacro, vx01.urdf.xacro]
2026-04-24 chore: update motor control parameters, servo limits, and simulation constants in URDF
    [vx01.urdf.xacro]
2026-04-24 chore: enable lock step and update rotor moment constants in URDF model
    [vx01.urdf.xacro]
2026-04-24 chore: adjust simulation spawn height and reset gazebo coordinate transformation parameters
    [vx01.urdf.xacro]
2026-04-24 feat: add robot namespace and update motor control parameters in ArduPilotPlugin configuration
    [vx01.urdf.xacro]
2026-04-24 chore: update motor control parameters and constants in urdf xacro
    [vx01.urdf.xacro]
2026-04-24 chore: update propeller controller multiplier and p_gain values in URDF
    [vx01.urdf.xacro]
2026-04-24 chore: tune motor control parameters and disable spin-on-arm for simulation stability
    [ardupilot_sim_bypass.param, vx01.urdf.xacro]
2026-04-24 chore: update ArduPilot serial parameters and tune motor controller gains in URDF
    [ardupilot_sim_bypass.param, vx01.urdf.xacro]
2026-04-24 refactor: update propeller inertial properties, joint limits, and motor controller gains for improved stability
    [arm_0.xacro, arm_1.xacro, arm_2.xacro, arm_3.xacro, vx01.urdf.xacro]
2026-04-25 refactor: update drone motor configuration, ArduPilot parameters, and flight management logic to include automated landing after a timed hover.
    [ardupilot_sim_bypass.param, vx01.urdf.xacro]
2026-04-25 feat: enable orientation output in IMU sensor configuration
    [imu.xacro]
2026-04-25 chore: enable compass and simulation magnetometer in ArduPilot bypass parameters
    [ardupilot_sim_bypass.param]
2026-04-25 refactor: update flight sequence to arm in STABILIZE before switching to GUIDED for takeoff
2026-04-25 refactor: update motor control parameters and streamline flight mode transition to GUIDED for takeoff
    [vx01.urdf.xacro]
2026-04-25 chore: update motor control multipliers, offsets, and command limits in URDF
    [vx01.urdf.xacro]
2026-04-25 chore: update PID gains and command limits for propeller velocity controllers
    [vx01.urdf.xacro]
2026-04-25 chore: update ArduPilot simulation parameters for rate controller and filtering settings
    [ardupilot_sim_bypass.param]
2026-04-25 chore: update ArduPilot rate controller gains and motor slew parameters in simulation config
    [ardupilot_sim_bypass.param]
2026-04-26 chore: normalize arm joint orientations and update ArduPilot PID tuning parameters
    [ardupilot_sim_bypass.param, arm_0.xacro, arm_1.xacro, arm_2.xacro, arm_3.xacro]
2026-04-26 refactor: update ArduPilot SITL parameters, adjust launch timing, and add EKF health validation to drone flight manager
    [ardupilot_sim_bypass.param, vx01.urdf.xacro]
2026-04-26 refactor: update friction coefficients in simulation and remove IMU bias noise parameters
    [imu.xacro, vx01_sim.xacro]
2026-04-26 refactor: swap motor channels and configurations for prop_1 and prop_2
    [vx01.urdf.xacro]
2026-04-26 chore: reduce propeller mass and increase motor control multiplier in URDF configuration
    [arm_0.xacro, arm_1.xacro, arm_2.xacro, arm_3.xacro, vx01.urdf.xacro]
2026-04-26 chore: increase p_gain from 0.5 to 5.0 for velocity servos in URDF description
    [vx01.urdf.xacro]
2026-04-26 fix: invert motor multipliers for prop_1 and prop_3 to correct rotation direction
    [vx01.urdf.xacro]
2026-04-26 chore: tune MAVROS connection timeouts and update motor control parameters in URDF
    [vx01.urdf.xacro]
2026-04-27 feat: add teleop launch buttons and manual control toggles to hexapod and drone dashboards
2026-04-27 Fix: Add camera SDK path to LD_LIBRARY_PATH
2026-04-27 chore: update IMU port to persistent /dev/ttyIMU and clean up configuration file comments
2026-04-28 Fix: Pin Maestro symlink to Command Port (Interface 0)
2026-04-28 feat: add device rule for new camera, standardize image topics via remapping, and include web_video_server in launch
2026-04-28 refactor: update hexapod gait parameters, calibrate URDF kinematics, and disable MAVROS/IMU nodes with delayed camera launch
    [leg_0.xacro]
2026-04-28 chore: update gait parameters and apply tibia joint offset for high-precision movement
2026-04-28 fix: set reversed flag to false for all hexapod leg servos in servo_mapping.yaml
    [servo_mapping.yaml]
2026-04-28 refactor: update gait parameters, adjust tibia angle offsets, and invert servo directions for improved locomotion stability
    [servo_mapping.yaml]
2026-04-28 chore: adjust hexapod gait parameters for improved reachability and stability
    [hexapod.yaml]
2026-04-28 refactor: remove joint offset bias in locomotion node and update gait configuration parameters
2026-04-29 chore: adjust home Z-height, increase stand duration, and apply joint offset corrections to locomotion kinematics
    [leg_0.xacro]
2026-04-29 refactor: update hexapod gait configuration and add robust error handling to backend server startup
    [hexapod.yaml]
2026-04-29 refactor: implement decoupled pop-and-stride swing trajectory for hexapod legs
2026-04-29 refactor: invert joint rotation axes to z-axis positive for all leg joints
    [leg_0.xacro, leg_1.xacro, leg_2.xacro, leg_3.xacro, leg_4.xacro, leg_5.xacro]
2026-04-29 refactor: invert joint rotation axes in URDF and update inverse kinematics offsets in hexapod controller
    [leg_0.xacro, leg_1.xacro, leg_2.xacro, leg_3.xacro, leg_4.xacro, leg_5.xacro]
2026-04-29 chore: update hexapod gait parameters and home position for increased stability
    [hexapod.yaml]
2026-04-29 chore: update stand-pose joint commands and home position for improved stability and clearance
    [hexapod.yaml]
2026-04-29 chore: update stand-pose joint commands and home position for improved walking IK alignment
2026-05-05 build: add host network driver option to buildx builder creation
2026-05-11 feat: update camera resolution settings, fix hexapod angle calculation, and add MAVROS distance sensor configuration
2026-05-11 Fix MAVROS distance sensor ROS 2 config format
2026-05-11 Add QoS relay node to fix MAVROS Best Effort telemetry not reaching Dashboard via rosbridge
    [qos_relay.py]
2026-05-12 docs: Generate clean tree-based READMEs matching the original camera documentation format
2026-07-06 pcb files added
    [VX-01.kicad_pcb, VX-01.kicad_sch]
